ricci07/Blast-Furnace-Temperature-Sensor-PCB/Screens/Report 3D Screens/HEADERS.png

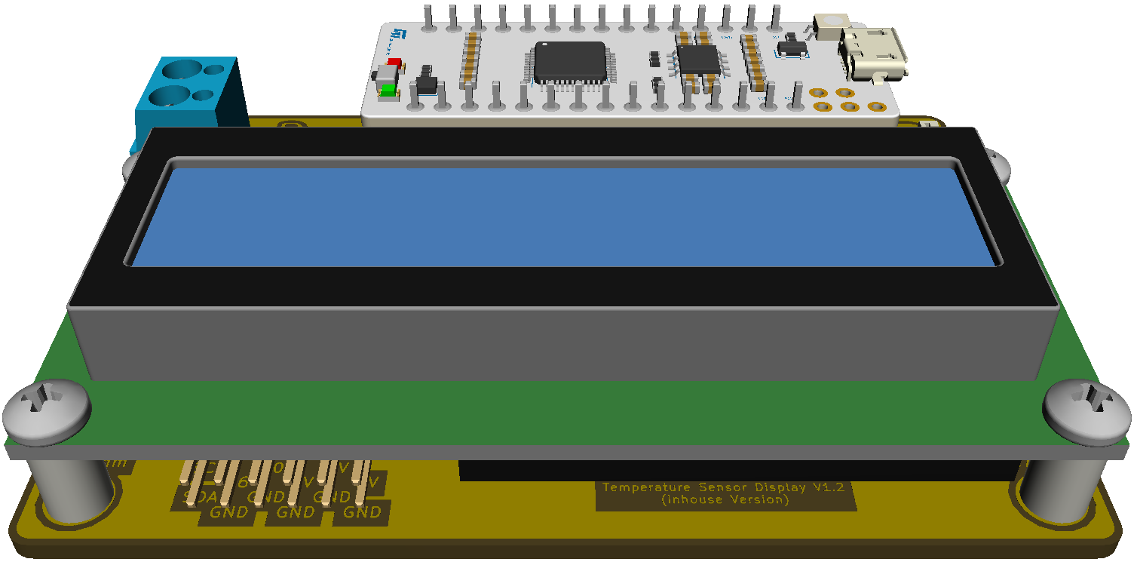
Screens/Report 3D Screens/HEADERS.png
