ricci07/Blast-Furnace-Temperature-Sensor-PCB/Budget Screenshot/Budget.png

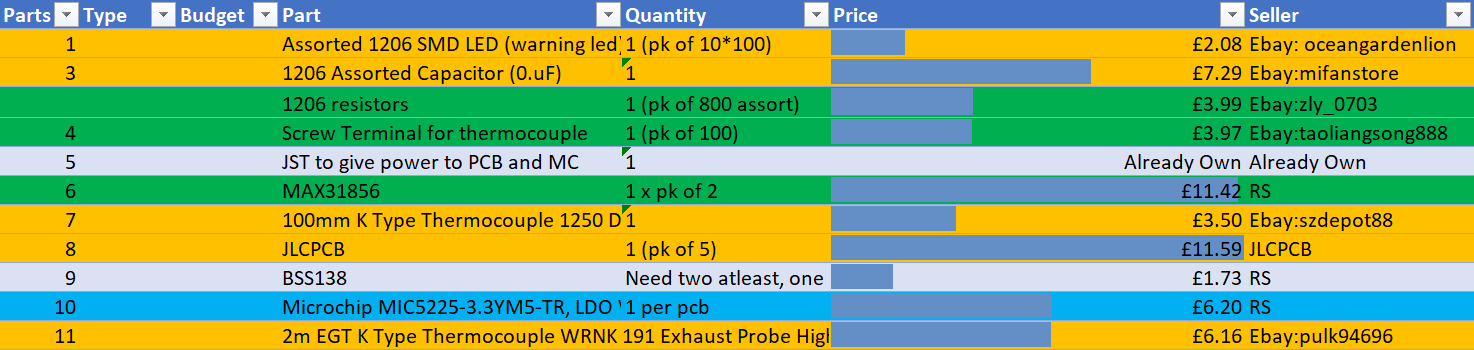
Budget Screenshot/Budget.png
