ricci07/Blast-Furnace-Temperature-Sensor-PCB/Gerber Files/Blast Furnace V1.2 (Chris Version)/Extra/V.2 PCB.png

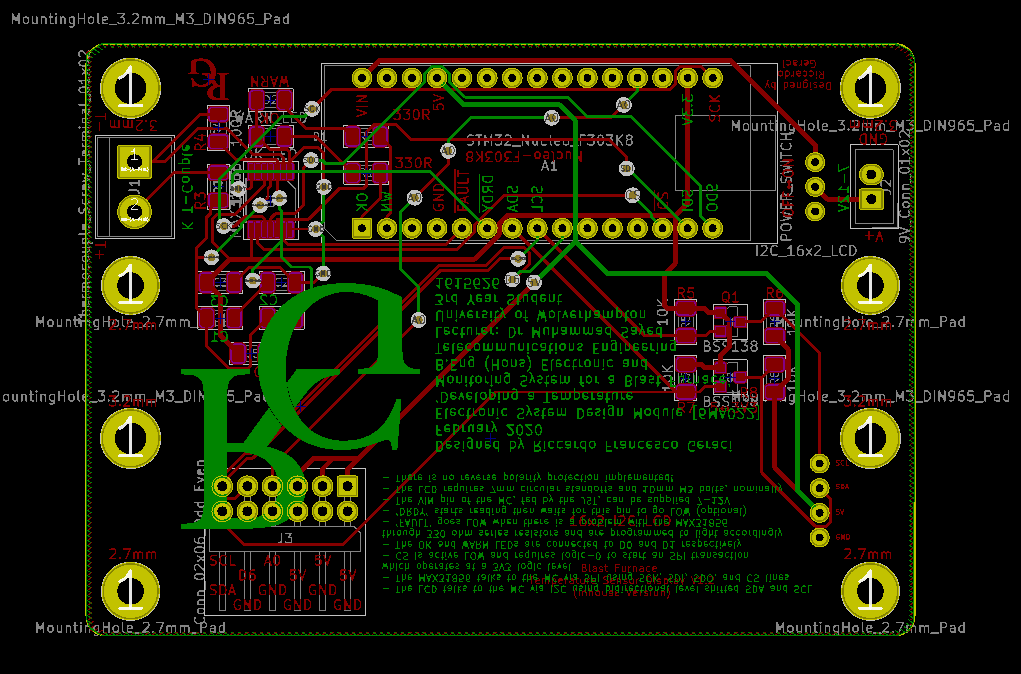
Gerber Files/Blast Furnace V1.2 (Chris Version)/Extra/V.2 PCB.png
