ricci07/Blast-Furnace-Temperature-Sensor-PCB/Gerber Files/V1.2.2 Chris Version, ALL back copper!/Extra/PCB.png

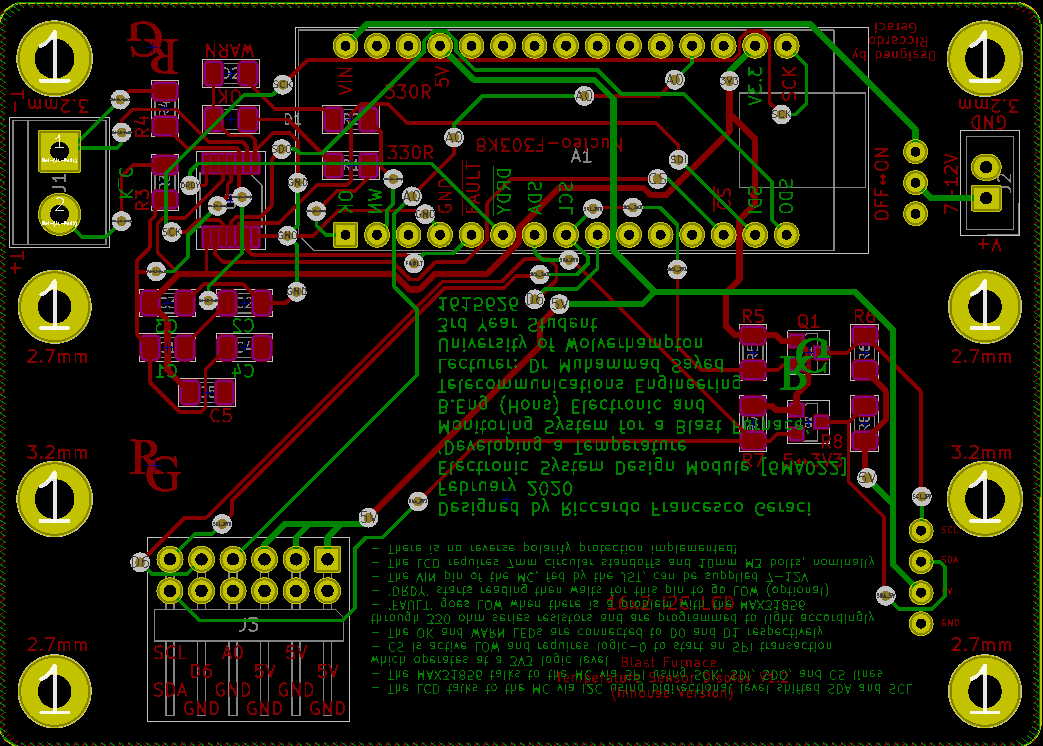
Gerber Files/V1.2.2 Chris Version, ALL back copper!/Extra/PCB.png
