ricci07/Blast-Furnace-Temperature-Sensor-PCB/Gerber Files/V1.2.3 Chris Version, LCD Pad Bigger/Extra/These pads were too small, could not insert LCD header pins (Increased to correct size).png

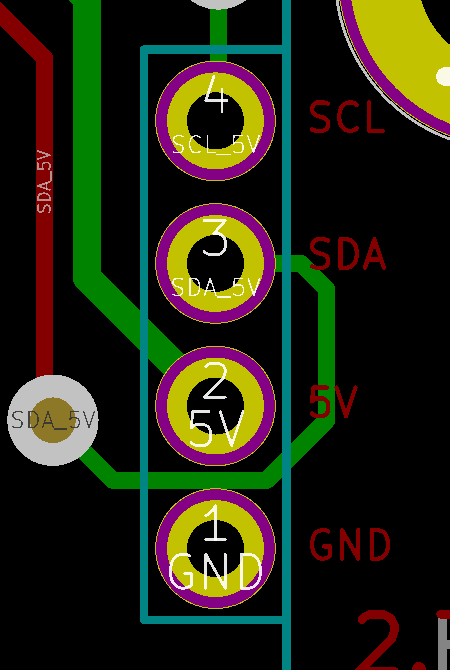
Gerber Files/V1.2.3 Chris Version, LCD Pad Bigger/Extra/These pads were too small, could not insert LCD header pins (Increased to correct size).png
