ricci07/Blast-Furnace-Temperature-Sensor-PCB/Screens/Freerouting/After.png

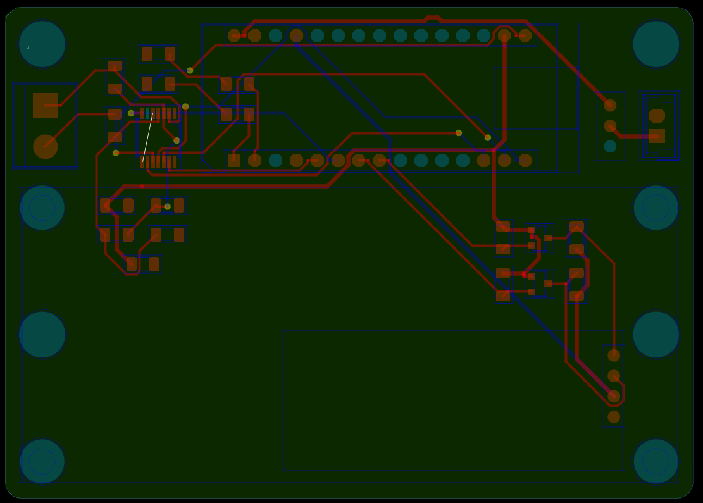
Screens/Freerouting/After.png
