ricci07/Blast-Furnace-Temperature-Sensor-PCB/Screens/Freerouting/After_no_bg.png

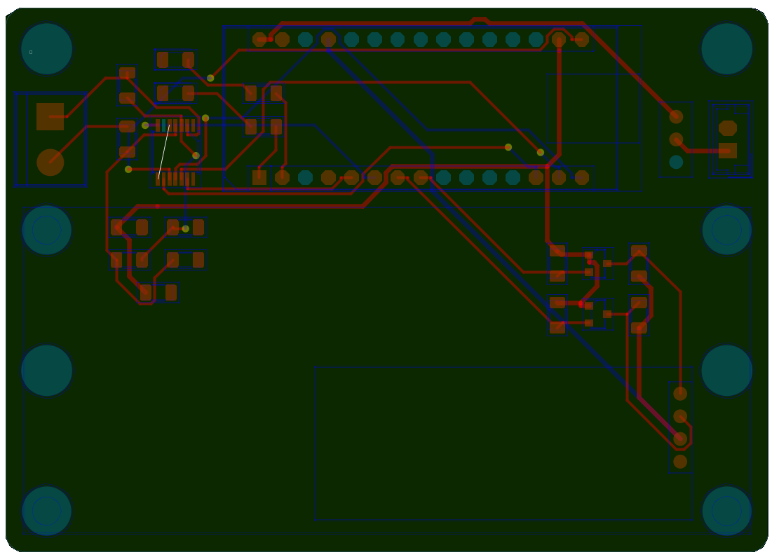
Screens/Freerouting/After_no_bg.png
