ricci07/Blast-Furnace-Temperature-Sensor-PCB/Screens/Freerouting/Before.png

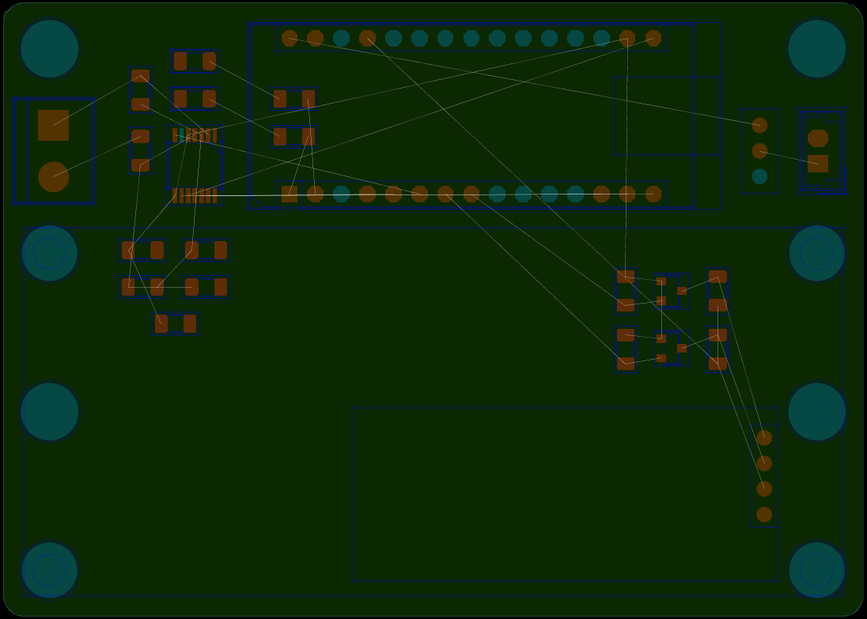
Screens/Freerouting/Before.png
