ricci07/Blast-Furnace-Temperature-Sensor-PCB/Screens/PCB/PCB.png

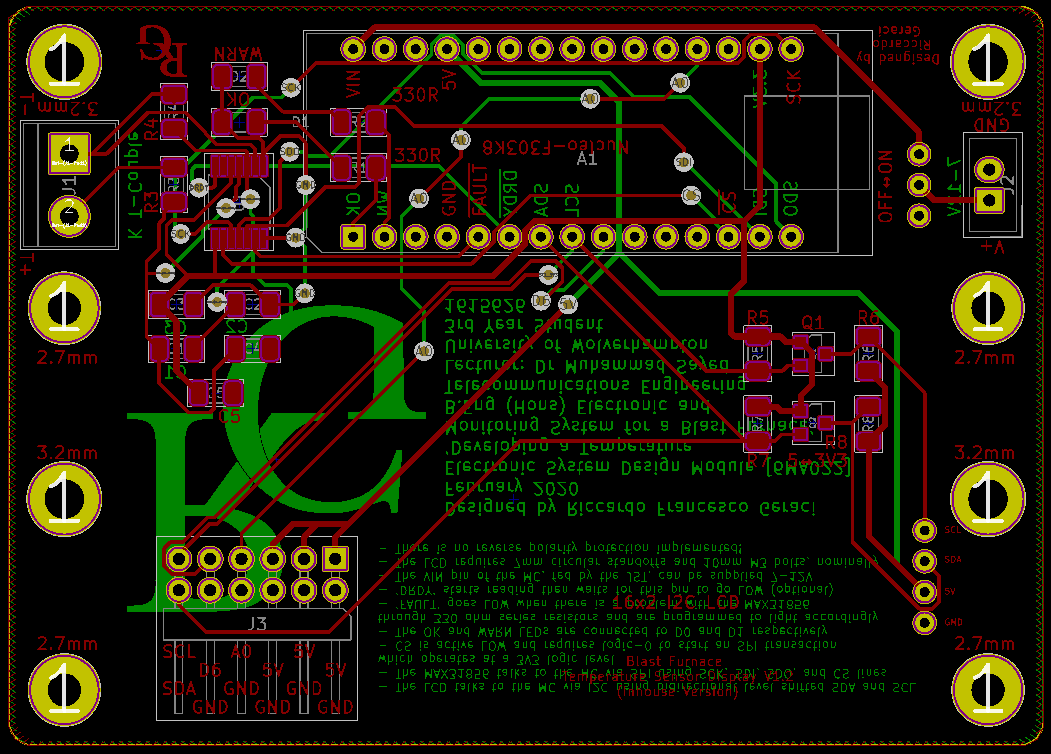
Screens/PCB/PCB.png
