ricci07/Blast-Furnace-Temperature-Sensor-PCB/Screens/PCB/PCB_no_bg.png

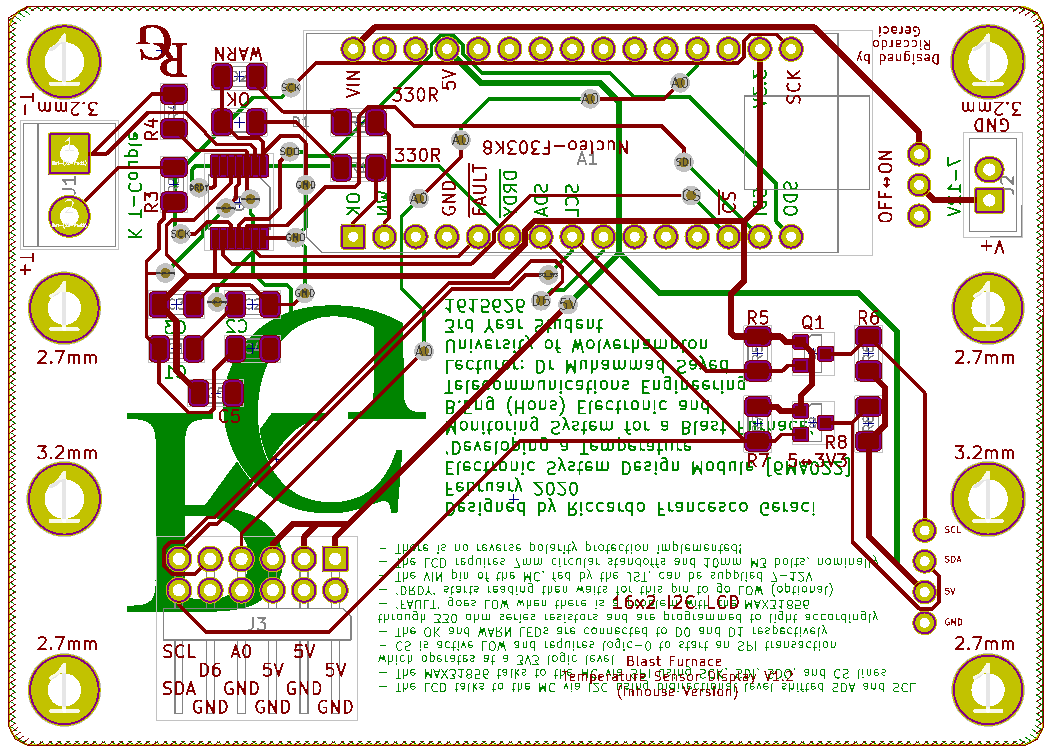
Screens/PCB/PCB_no_bg.png
