ricci07/Blast-Furnace-Temperature-Sensor-PCB/Screens/PCB/V1.2.3/V1.2.3.png

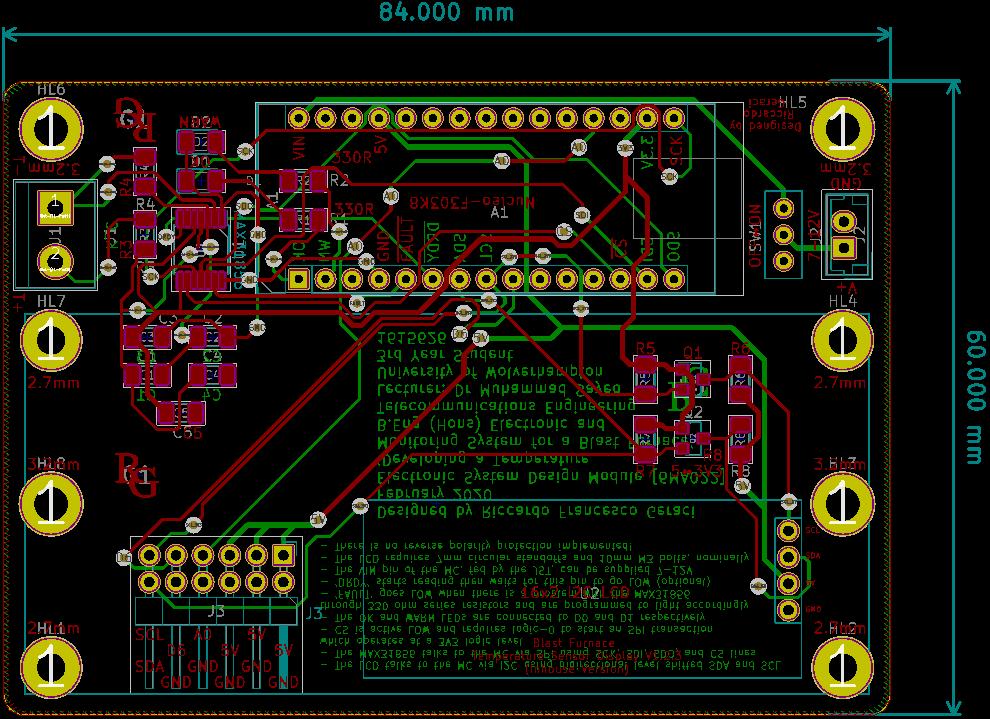
Screens/PCB/V1.2.3/V1.2.3.png
