ricci07/Blast-Furnace-Temperature-Sensor-PCB/Screens/PCB/V1.2.3/V1.2.3_no_bg.png

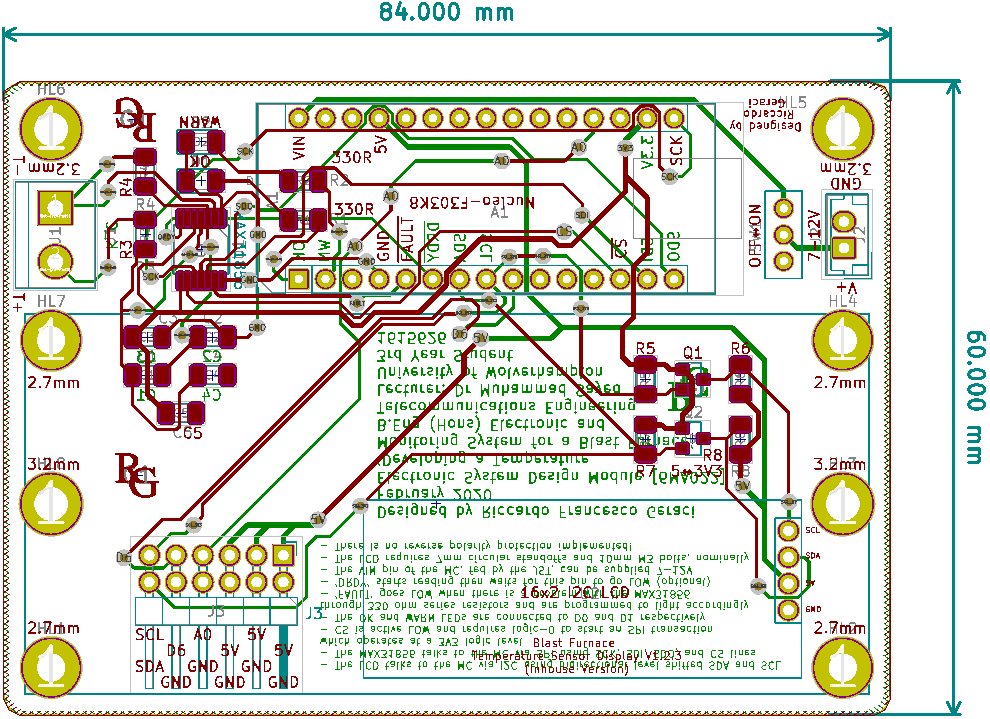
Screens/PCB/V1.2.3/V1.2.3_no_bg.png
