ricci07/Blast-Furnace-Temperature-Sensor-PCB/Simulation of Level Shifter/Result/Schematic 3V3_to_5V/Schematic.png

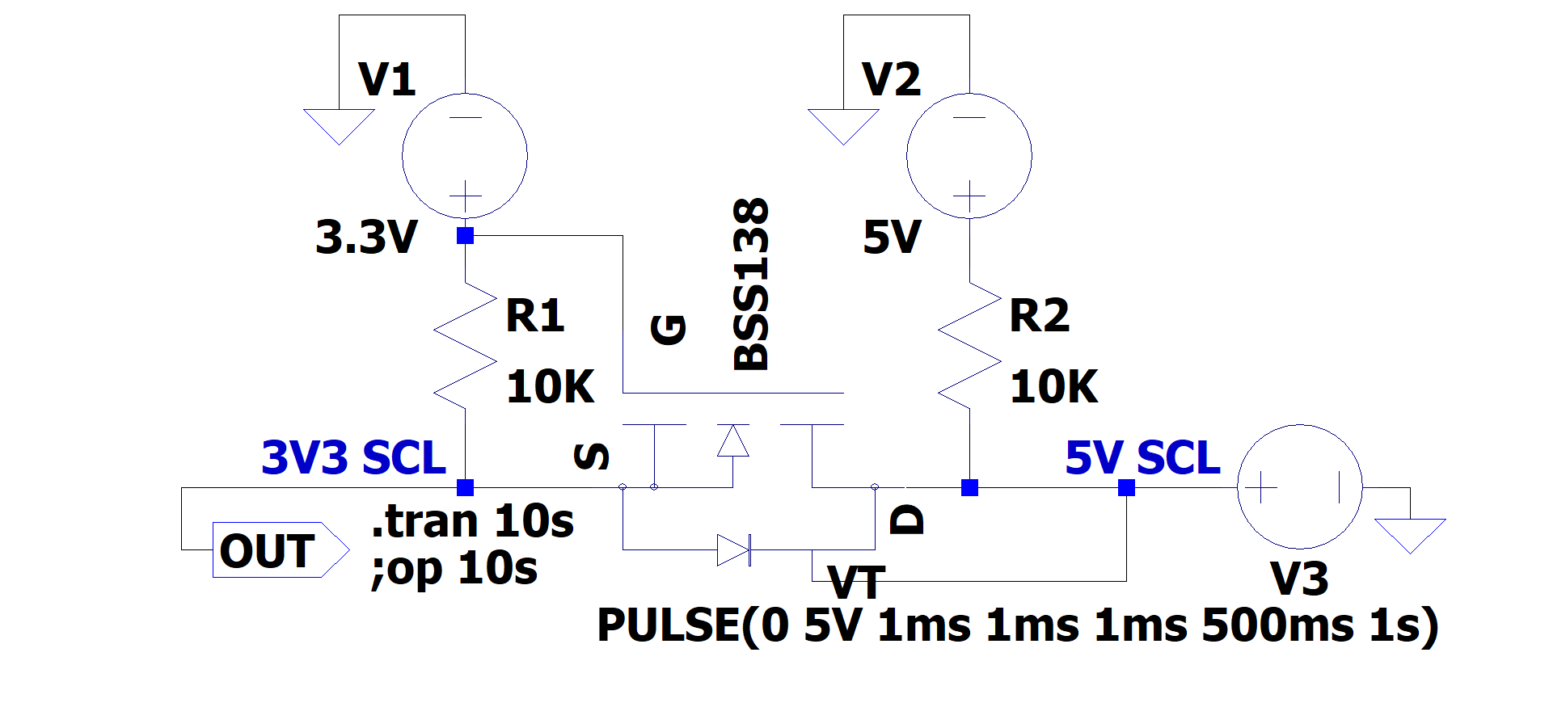
Simulation of Level Shifter/Result/Schematic 3V3_to_5V/Schematic.png
