ricci07/Blast-Furnace-Temperature-Sensor-PCB/Simulation of Level Shifter/Result/Schematic 5V_to_3V3/3V3_to_5V_Transient.png

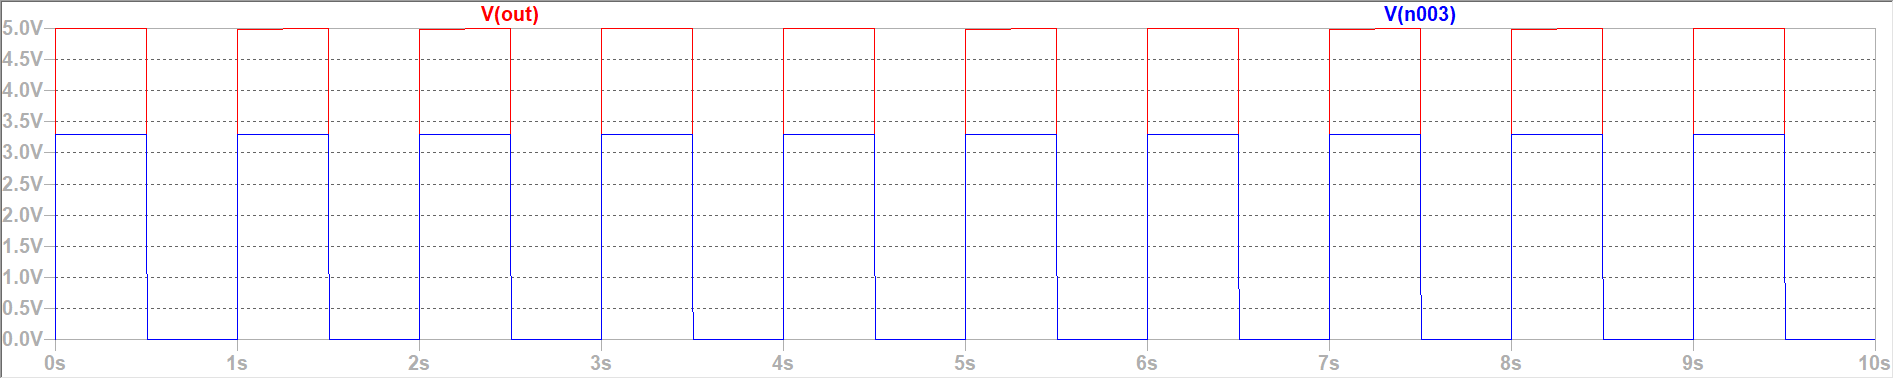
Simulation of Level Shifter/Result/Schematic 5V_to_3V3/3V3_to_5V_Transient.png
