ricci07/Blast-Furnace-Temperature-Sensor-PCB/Simulation of Level Shifter/Result of simulation with BS1138 Mosfet.png

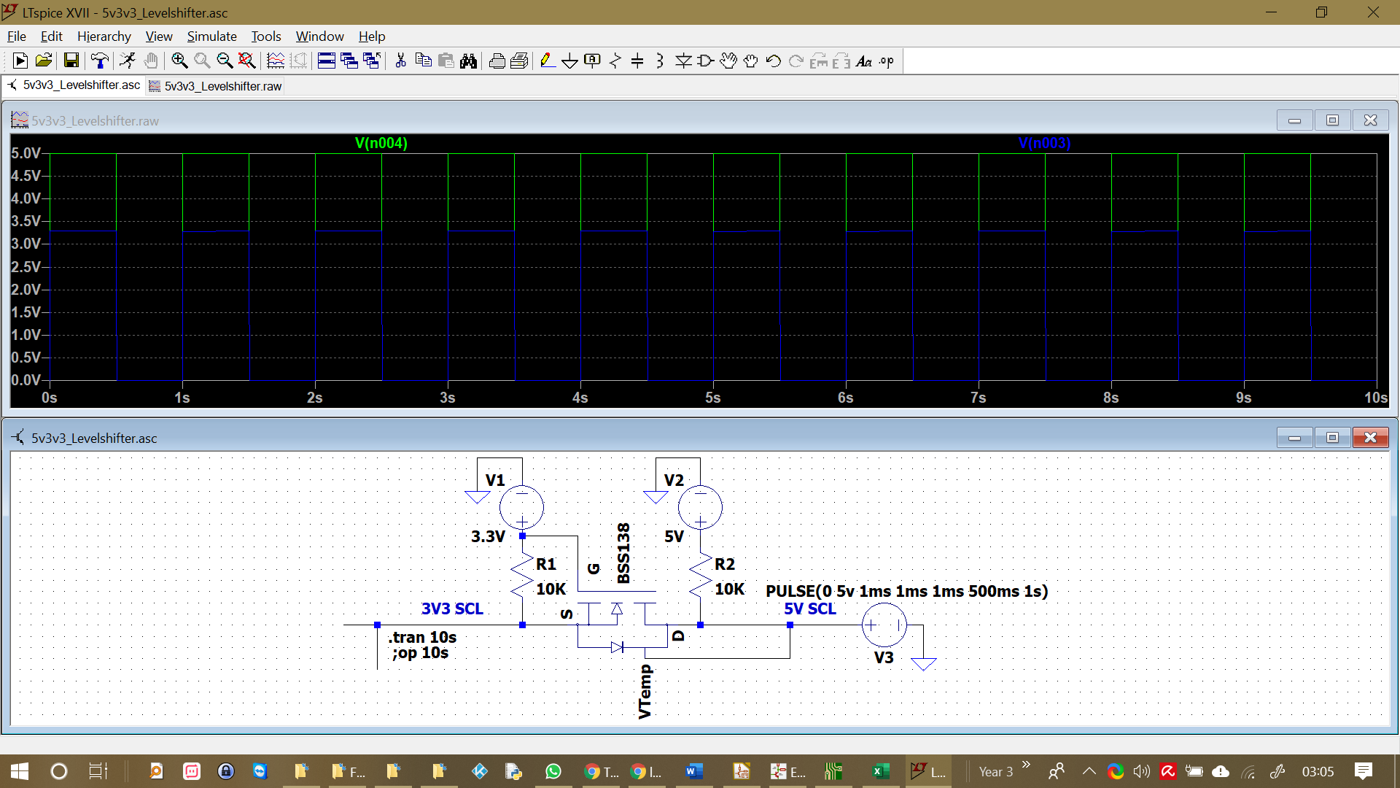
Simulation of Level Shifter/Result of simulation with BS1138 Mosfet.png
