ricci07/Blast-Furnace-Temperature-Sensor-PCB/Simulation of Level Shifter/Result of Simulation.png

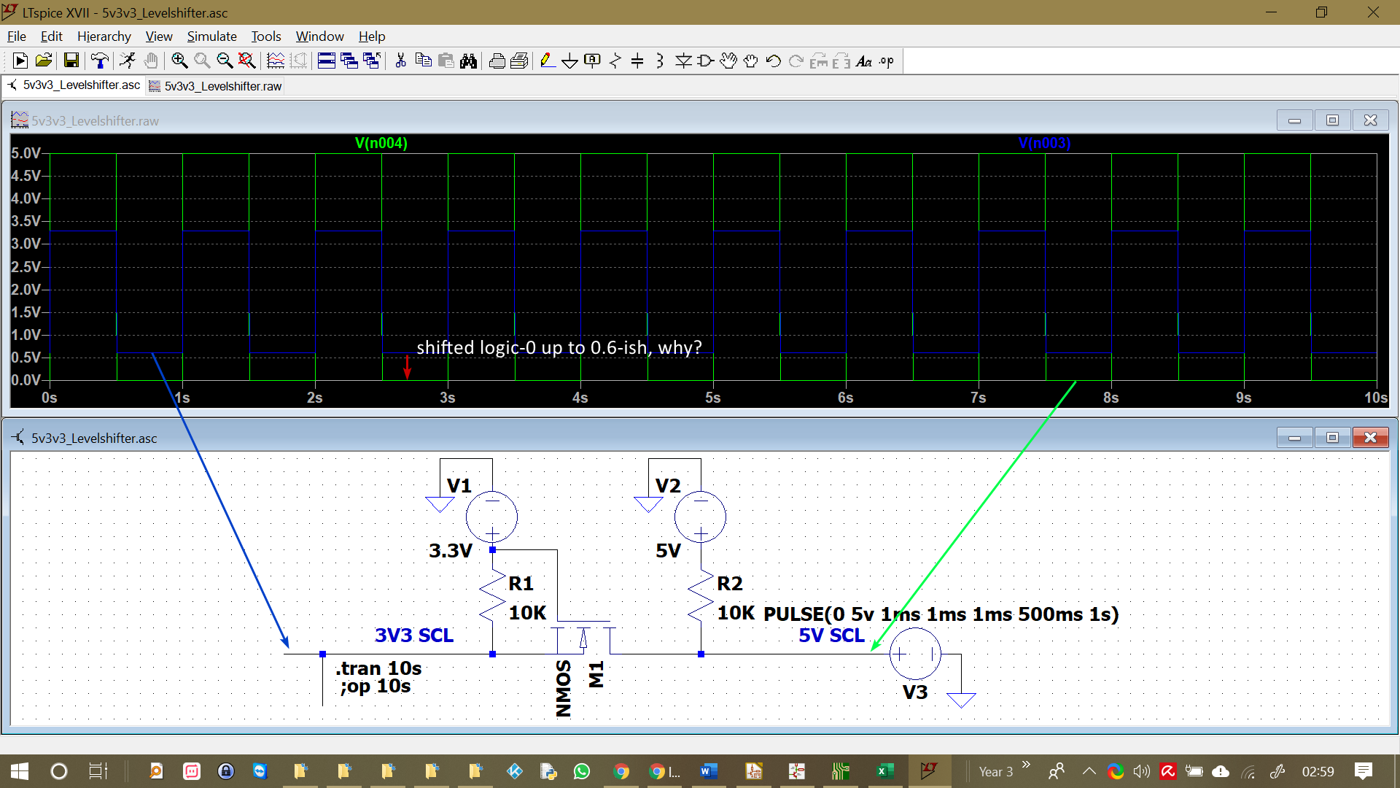
Simulation of Level Shifter/Result of Simulation.png
