ricci07/Blast-Furnace-Temperature-Sensor-PCB/Gerber Files/Blast Furnace V1.2 (Chris Version)/Extra/V.2 Schematic.pdf

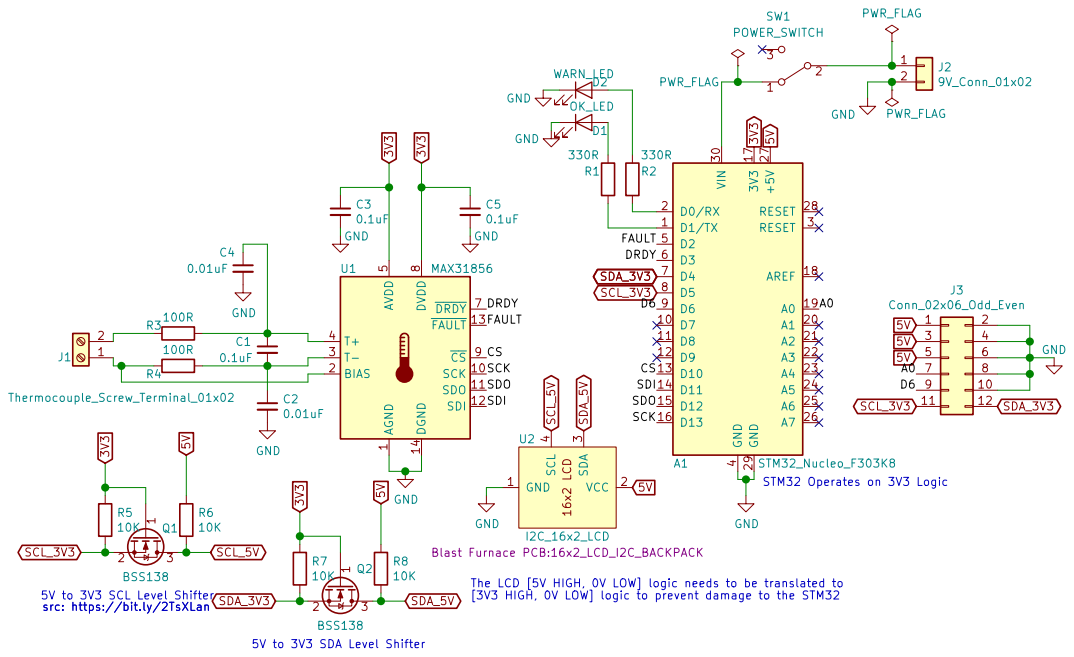
[picture p23: page 1]

1 SCK 10 SDO 11 SDI 12 FAULT 13 DGND 14 BIAS 2 T- 3 T+ 4 AVDD

The LCD [5V HIGH, 0V LOW] logic needs to be translated to

src: https://bit.ly/2TsXLan
