ricci07/Blast-Furnace-Temperature-Sensor-PCB/Blast Furnace PCB.pdf

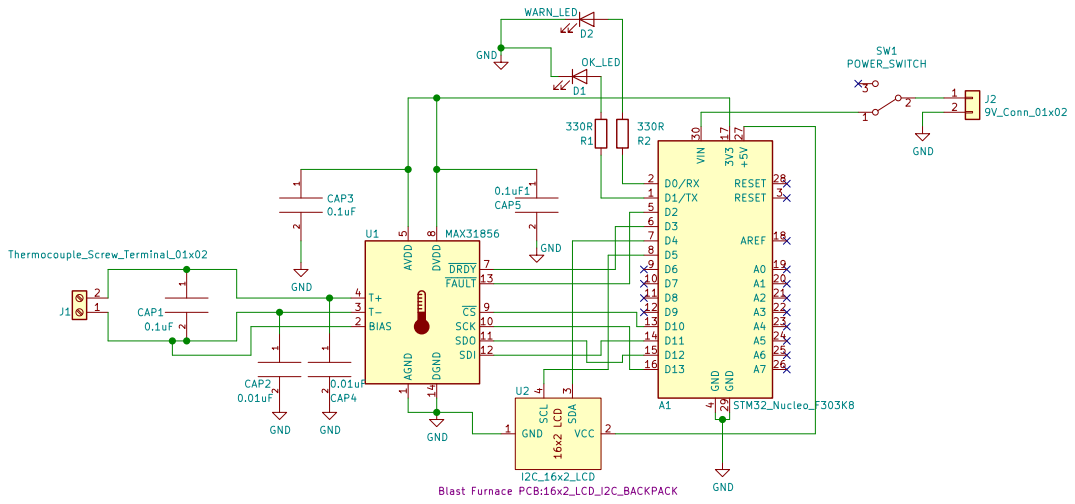
[picture p24: page 1]
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

Id: 1/1 Title: File: Blast Furnace PCB.sch Sheet: / AGND
