ricci07/Blast-Furnace-Temperature-Sensor-PCB/Simulation of Level Shifter/5v3v3_Levelshifter.asc

R1: res; 10K
R2: res; 10K
U1: BSS138_Best
V1: voltage; 3.3V
V2: voltage; 5V
V3: voltage; PULSE(0 5V 1ms 1ms 1ms 500ms 1s)
Named nets: 0, OUT
3V3 SCL
5V SCL
;op 10s
.tran 10s
