ricci07/Blast-Furnace-Temperature-Sensor-PCB/(list of files, drawings)

Other design files:
FreeRouting File/Blast Furnace PCB.dsn
