ricci07/Blast-Furnace-Temperature-Sensor-PCB/Blast Furnace PCB.kicad_pcb

## KiCad design Blast Furnace PCB.kicad_pcb (2020-03-13)

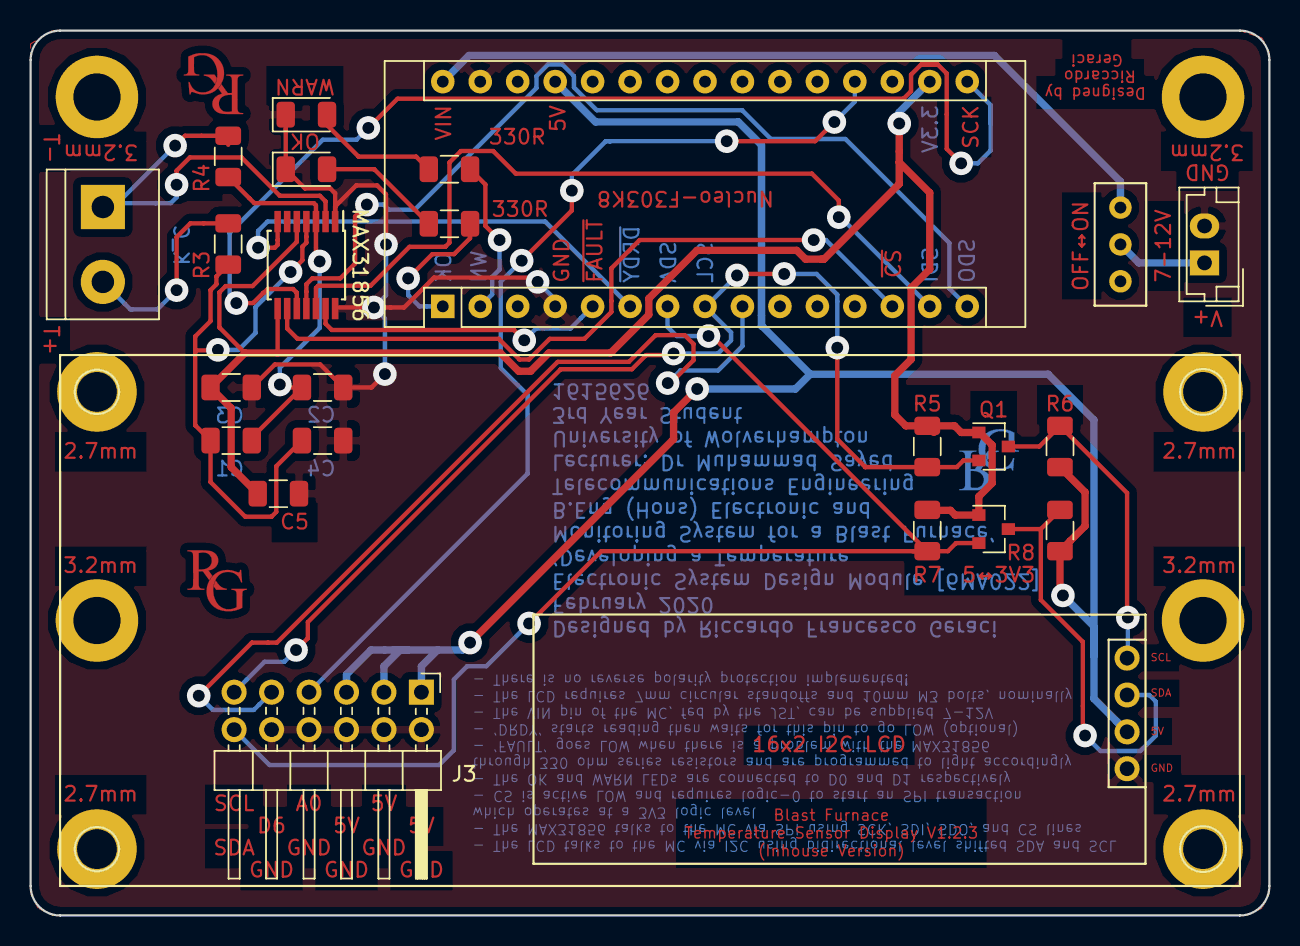
[picture p25: board Blast Furnace PCB.kicad_pcb from above]

Board: 2 copper layers, 84.0 x 60.0 mm, 35 parts (1 on the bottom side), 25 nets.

Parts:
A1: STM32_Nucleo_F303K8; Arduino_Nano_Header_Nucleo_F303K8
C1, C3, C5: 0.1uF; C_1206_3216Metric
C2, C4: 0.01uF; C_1206_3216Metric
D1: OK_LED; LED_1206_3216Metric
D2: WARN_LED; LED_1206_3216Metric
G1, G1#2, G1#3: LOGO; im calling the police
HL1, HL2, HL4, HL7: MountingHole_2.7mm_Pad
HL3, HL5, HL6, HL8: MountingHole_3.2mm_M3_DIN965_Pad
J1: Thermocouple_Screw_Terminal_01x02; TerminalBlock_bornier-2_P5.08mm
J2: 9V_Conn_01x02; JST_EH_B02B-EH-A_1x02_P2.50mm_Vertical
J3: Conn_02x06_Odd_Even; PinHeader_2x06_P2.54mm_Horizontal
Q1, Q2: BSS138; SOT-23
R1, R2: 330R; R_1206_3216Metric
R3, R4: 100R; R_1206_3216Metric
R5, R6, R7, R8: 10K; R_1206_3216Metric
SW1: POWER_SWITCH; 50VDC_0.5_SPDT_SWITCH
U1: MAX31856; TSSOP-14_4.4x5mm_P0.65mm
U2: I2C_16x2_LCD; 16x2_LCD_I2C_BACKPACK

Connections:
3V3: A1.17, C3.1, C5.1, Q1.1, Q2.1, R5.1, R7.1, U1.5, U1.8
5V: A1.27, J3.1, J3.3, J3.5, R6.1, R8.1, U2.2
/A0: A1.19, J3.7
/CS: A1.13, U1.9
/D6: A1.9, J3.9
/DRDY: A1.6, U1.7
/FAULT: A1.5, U1.13
/SCK: A1.16, U1.10
/SDI: A1.14, U1.12
/SDO: A1.15, U1.11
GND: A1.4, A1.29, C2.2, C3.2, C4.2, C5.2, D1.1, D2.1, J2.2, J3.2, J3.4, J3.6, J3.8, J3.10, U1.1, U1.14, U2.1
unnamed: A1.1, R1.2
unnamed: A1.2, R2.2
unnamed: A1.30, SW1.1
unnamed: C1.1, C4.1, R3.1, U1.4
unnamed: C1.2, C2.1, R4.1, U1.3
unnamed: D1.2, R1.1
unnamed: D2.2, R2.1
unnamed: J1.1, R4.2, U1.2
unnamed: J1.2, R3.2
unnamed: J2.1, SW1.2
SCL_3V3: A1.8, J3.11, Q1.2, R5.2
SCL_5V: Q1.3, R6.2, U2.4
SDA_3V3: A1.7, J3.12, Q2.2, R7.2
SDA_5V: Q2.3, R8.2, U2.3
