ricci07/Blast-Furnace-Temperature-Sensor-PCB/Test flags/Test flags.kicad_pcb

## KiCad design Test flags/Test flags.kicad_pcb (2020-03-11)

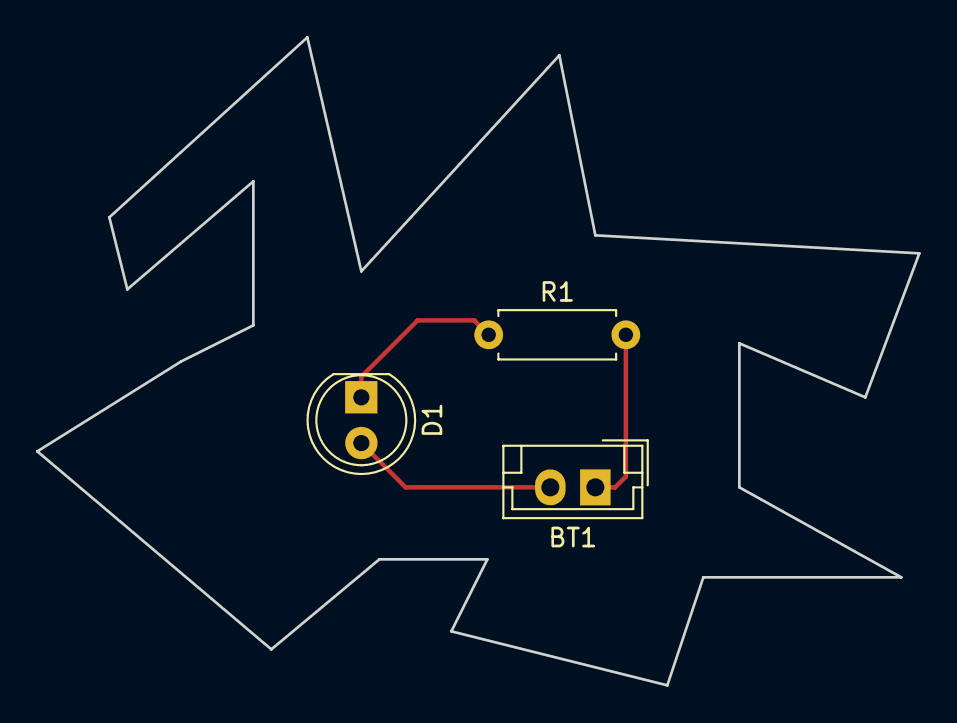
[picture p26: board Test flags.kicad_pcb from above]

Board: 2 copper layers, 49.0 x 36.0 mm, 3 parts (0 on the bottom side), 3 nets.

Parts:
BT1: 12V; JST_EH_B02B-EH-A_1x02_P2.50mm_Vertical
D1: LED; LED_D5.0mm
R1: 330R; R_Axial_DIN0207_L6.3mm_D2.5mm_P7.62mm_Horizontal

Connections:
unnamed: BT1.1, R1.2
unnamed: BT1.2, D1.2
unnamed: D1.1, R1.1
