ricci07/Blast-Furnace-Temperature-Sensor-PCB/(commit log)

2020-03-11 After backcopper through hole version send to chris, after I fixed, after I spoke with in lab
    [Blast Furnace PCB-NPTH-drl_map.dxf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]
2020-03-11 added silly test track
    [Blast Furnace PCB.kicad_pcb]
2020-03-11 Connected the missed nucleo pads that were meant to be backcopper as chris' email pointed out and made them all on backcopper as they should have been
    [Blast Furnace PCB.kicad_pcb]
2020-03-11 Created gerber files for V1.2.2, and sent to chris
    [Blast Furnace PCB-NPTH-drl_map.dxf, Blast Furnace PCB-PTH-drl_map.dxf, Blast Furnace PCB.kicad_pcb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]
2020-03-11 Nothing much, deleted some old .dxf drill maps
    [Blast Furnace PCB-NPTH-drl_map.dxf, Blast Furnace PCB-PTH-drl_map.dxf]
2020-03-12 Increased the size of the LCD pins from 0.8 hole, 1.6 width to 1.0 hole 1.7 wide
2020-03-13 standard save stuff
    [Blast Furnace PCB.kicad_pcb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]
2020-03-27 Added all the mbed code used to program the STM32F303K8
2020-03-27 fixed main.cpp file formatting
    [Main.cpp]
